VimuthWickramasinghe/Energy-Monitoring-System/firmware/README.md

The folder includes code for Platform IO for esp32-wroom devkit
Recreate the project If the board is wrong
