VimuthWickramasinghe/Energy-Monitoring-System/design/notes.md

# module device naming convention

the device name should start with 'ems' followed by version number and the uniqe product id for example
