VimuthWickramasinghe/Energy-Monitoring-System/docs/docs/Circuit/index.md

---
sidebar_position: 6
title: Circuit Diagrams
description: All circuit diagrams
---

# Energy Monitoring System module circuit

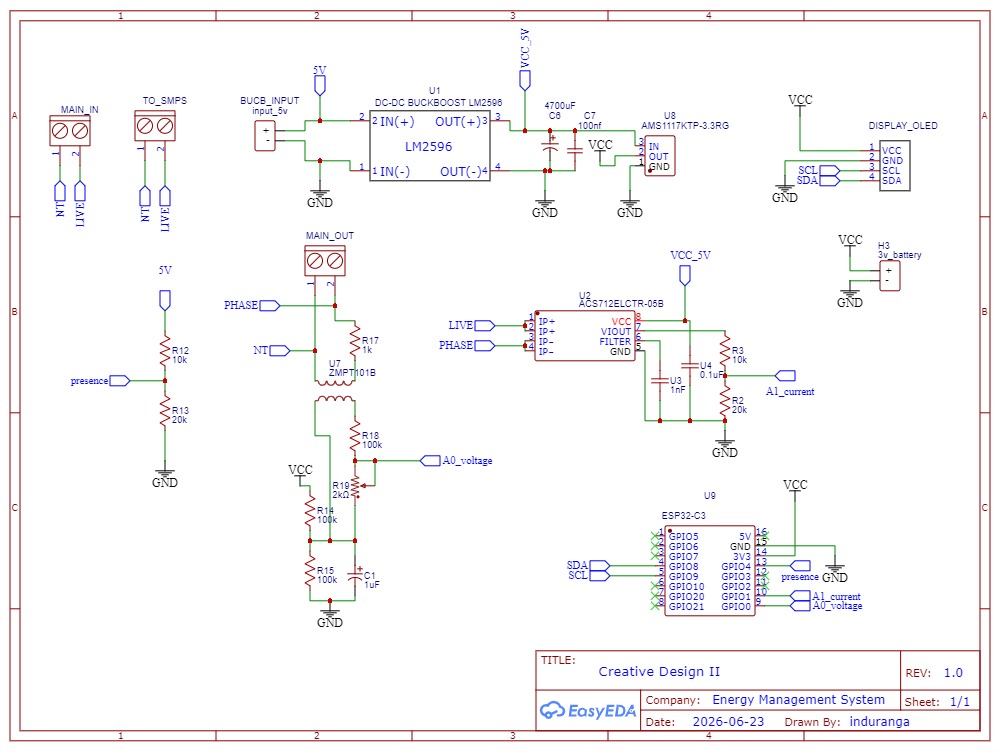
[picture p2: docs/static/assets/circuit.jpeg]


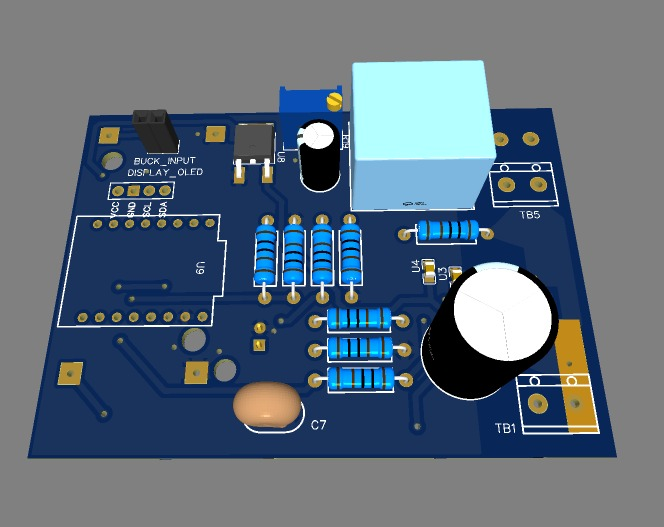
[picture p3: docs/static/assets/circuit3D.jpeg]


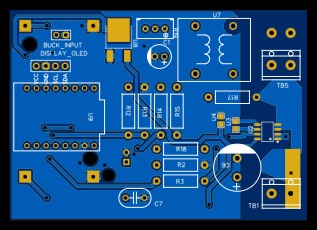
[picture p4: docs/static/assets/circuitPCB.jpeg]
