VimuthWickramasinghe/Energy-Monitoring-System/docs/docs/Database/index.md

---
sidebar_position: 6
title: Database
description: All Database related
---

# Database

## Supabase PostgresSQL

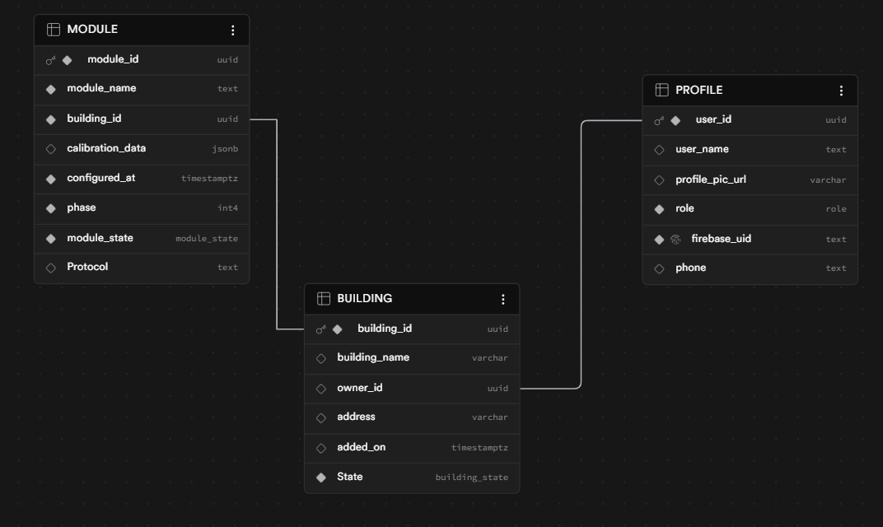
[picture p5: docs/static/assets/supabase-schema.png]


## MongoDB

saved as,

```json
{
    "_id": "6a43bda06c5d879fc38d957f",
    "device_id": "ems-esp-d09dd4d4db1c",
    "voltage": 206.09406,
    "current": 0.540048826,
    "apparent_power": 111.3008552,
    "real_power": 1605.705438,
    "power_factor": 1,
    "time": "2026-06-30T12:59:12.626Z",
    "__v": 0
  },
```
