VimuthWickramasinghe/Energy-Monitoring-System/docs/docs/Communication/index.md

---
sidebar_position: 5
title: Communication
description: Module Backend Communication MQTT Broker and HTTP integration, Client Server Communication (HTTP,Web Sockets),BLE.
---

# Energy Monitoring System
