VimuthWickramasinghe/Energy-Monitoring-System/docs/docs/Communication/PLC/index.md

---
sidebar_position: 5
title: Power Line Communication
description: Challenges, Hardware Implementation, Hardware Abstraction,Communication Protocol.
---

# Power Line Communication
