VimuthWickramasinghe/Energy-Monitoring-System/design/database/image.png

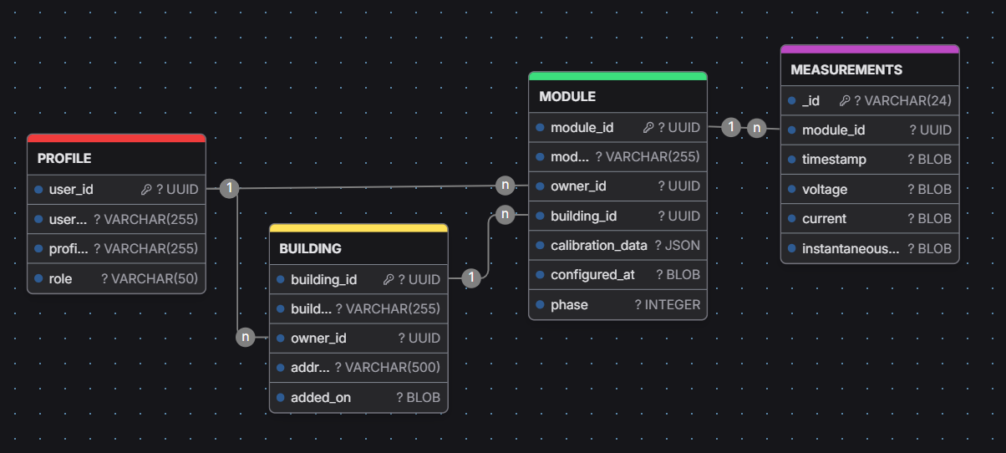
design/database/image.png
