VimuthWickramasinghe/Energy-Monitoring-System/(list of files, drawings)

Other design files:
hardware/ems_hardware.pdsprj
hardware/PCB_PCB_creative-design1_6_2026-06-22.json
hardware/PLC.pdsprj
hardware/Project Backups/PLC [20260607, 21-16-33].pdsprj
