VimuthWickramasinghe/Energy-Monitoring-System/(commit log)

2026-04-26 adding Proteus project files
    [ems_hardware.pdsprj]
2026-04-26 creating platformIO project for esp32 wo
2026-05-01 device page UI change
2026-05-01 big update for device page
2026-05-01 ⚠️ sharing local env
2026-05-01 frontend update Device mockdata Json files
2026-05-02 arduino code for sending data to the backend and mongoDB
2026-05-03 update for the buiding UI and device UI
2026-05-03 device page update
2026-05-05 fixing user flow
2026-05-05 flow chat update
2026-05-06 @planning user flow
2026-05-09 device page context update
2026-05-10 adding BLE device scan to configure the device
2026-05-10 Wifi provitioning error fixing BLE
    [WiFi_Provisioning_Test.ino, mongoDB_Test.ino]
2026-05-15 Live button colour change
2026-05-15 esp32 code update to send the data in the correct format
    [mongoDB_Test.ino]
2026-05-15 adding register device api code for configuration
2026-05-16 Refactor device distribution chart for improved layout and styling
2026-05-16 Improve logout button styling and animation in UserNav component
2026-05-16 none tested code for esp32
2026-05-16 Enhance UsageByCategory component: add colored border to device items for better visual distinction
2026-05-17 device data fetching from mongoDB
2026-05-18 BLE device config
2026-05-19 organize device page code
2026-05-20 Not getting PF correctly. Data sending methods , wifi connection working perfect. Reading sensor values correctly with auto calibration.
    [data_sending_code.ino, ems_firmaware_v1.ino, mongoDB_Test.ino]
2026-05-21 adding device configuration and BLE Provistioning
2026-05-21 adding a wifi provisioning button
2026-05-26 connecting the device to the backend
2026-05-27 adding a button to calibrate
2026-05-27 web socket
2026-05-28 setting calibration method more easy to update.
2026-05-28 setting up web socket
2026-05-28 landing page update
2026-06-10 adding support for Hall effect sensor
2026-06-10 feat: Implement backend to frontend alert integration with Socket.io
    - Added BACKEND_TO_FRONTEND_INTEGRATION.md for detailed integration steps.
    - Updated server.js to export io instance for alertService.
    - Modified alertService.js to emit alerts to frontend upon sending emails.
    - Created test endpoints for manual alert emission.
    - Developed frontend integration guide in FRONTEND_ALERT_INTEGRATION.md.
    - Implemented AlertContext for managing alert state in the frontend.
    - Created reusable alert components: AlertPanel, AlertBadge, AlertSummary, and AlertTimeline.
    - Added useAlertListener hook to listen for Socket.io alerts in the frontend.
    - Enhanced NotificationContext to support energy alerts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
2026-06-10 Fixing the unit of the power and energy according to device data
2026-06-10 fixing issues relate to hosting the backend
    [PLC [20260607, 21-16-33].pdsprj, PLC.pdsprj]
2026-06-23 adding Matlab Simulink files by @Methsahan
    [PCB_PCB_creative-design1_6_2026-06-22.json]
2026-06-25 a copy of with inter changeable current sensor
2026-06-25 adding device configuration options
2026-06-25 adding flexibility to change the board quickly
2026-06-26 configure code for easy setup for both esp32 c3 and esp32 dev boards
2026-06-30 updated firmware to run on a esp32 c3
2026-06-30 fix ui of device card inside the analytics page
2026-06-30 add Circuit and database documentationupdate
